KrivkaJ/Projekt_SOC_KiCad/Univerzalni_testovaci_platforma_nejen_pro_IoT_v1/Univerzalni_testovaci_platforma_nejen_pro_IoT_v1.kicad_pcb

## KiCad design Univerzalni_testovaci_platforma_nejen_pro_IoT_v1/Univerzalni_testovaci_platforma_nejen_pro_IoT_v1.kicad_pcb (2024-02-26)

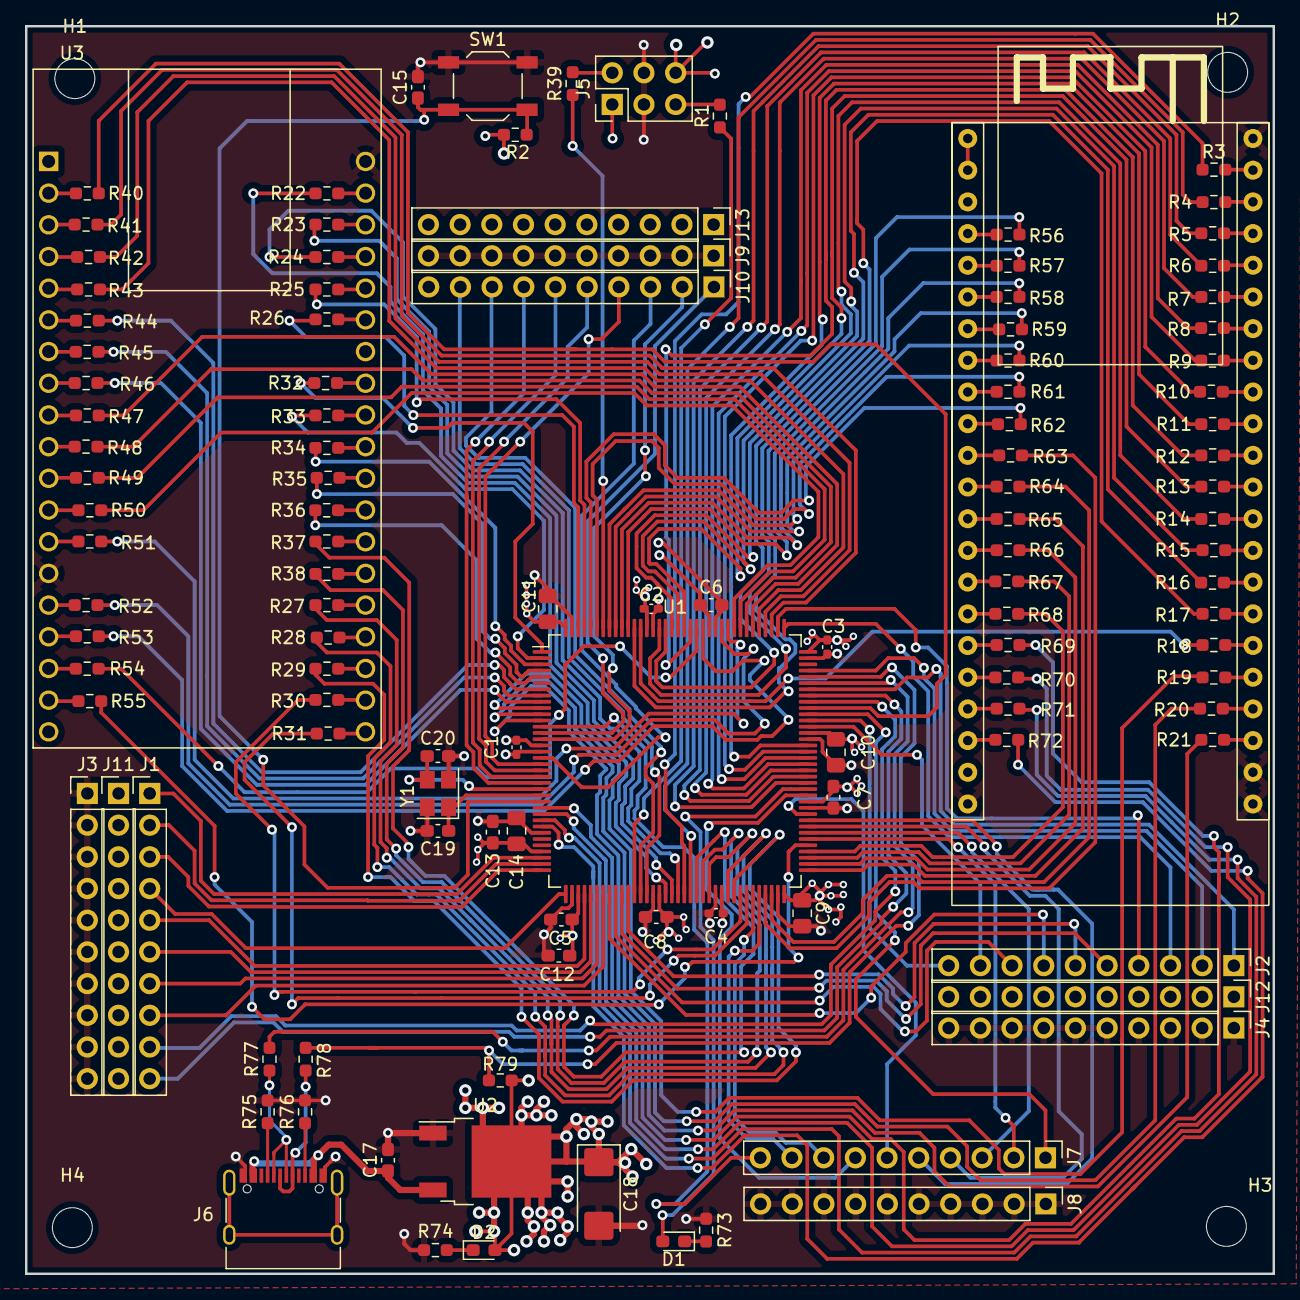
[picture p1: board Univerzalni_testovaci_platforma_nejen_pro_IoT_v1.kicad_pcb from above]

Board: 4 copper layers, 100.0 x 100.0 mm, 123 parts (0 on the bottom side), 197 nets.

Parts:
C1, C2, C3, C4: 10nF; C_0402_1005Metric_Pad0.74x0.62mm_HandSolder
C5, C6, C7, C8: 10nF; C_0603_1608Metric_Pad1.08x0.95mm_HandSolder
C9, C10, C11, C14: 10nF; C_0805_2012Metric_Pad1.18x1.45mm_HandSolder
C12, C15: 4.7uF; C_0603_1608Metric_Pad1.08x0.95mm_HandSolder
C13: 1uF; C_0603_1608Metric_Pad1.08x0.95mm_HandSolder
C17: 22uF; C_0603_1608Metric_Pad1.08x0.95mm_HandSolder
C18: 22µF solid tantalum; CP_EIA-6032-20_AVX-F_Pad2.25x2.35mm_HandSolder
C19, C20: 18pF; C_0603_1608Metric_Pad1.08x0.95mm_HandSolder
D1, D2: RED; LED_0603_1608Metric_Pad1.05x0.95mm_HandSolder
H1, H2, H3, H4: MountingHole; MountingHole_3.2mm_M3
J1, J2, J3, J4, J7, J8, J9, J10, J11, J12, J13: Conn_01x10_Male; PinHeader_1x10_P2.54mm_Vertical
J5: Conn_02x03_Counter_Clockwise; PinHeader_2x03_P2.54mm_Vertical
J6: USB_C_Receptacle; USB_C_Receptacle_XKB_U262-16XN-4BVC11
R1, R39: 100k; R_0603_1608Metric_Pad0.98x0.95mm_HandSolder
R2: 10k; R_0603_1608Metric_Pad0.98x0.95mm_HandSolder
R3, R4, R5, R6, R7, R8, R9, R10, R11, R12, R13, R14, R15, R16, R17, R18, R19, R20, R21, R22, R23, R24, R25, R26, R27, R28, R29, R30, R31, R32, R33, R34, R35, R36, R37, R38, R40, R41, R42, R43, R44, R45, R46, R47, R48, R49, R50, R51, R52, R53, R54, R55, R56, R57, R58, R59, R60, R61, R62, R63, R64, R65, R66, R67, R68, R69, R70, R71, R72: 220R; R_0603_1608Metric_Pad0.98x0.95mm_HandSolder
R73, R74, R79: 1k5; R_0603_1608Metric_Pad0.98x0.95mm_HandSolder
R75, R76: 5k1; R_0603_1608Metric_Pad0.98x0.95mm_HandSolder
R77, R78: 20R; R_0603_1608Metric_Pad0.98x0.95mm_HandSolder
SW1: SW_Push_Dual; SW_SPST_TL3342
U1: STM32F103ZETx; LQFP-144_20x20mm_P0.5mm
U2: AMS1117-3.3; TO-252-2
U3: ESP32-DEVKITC-32D; MODULE_ESP32-DEVKITC-32D
U4: ESP32-S3; ESP32-devkit_v1
Y1: 12Mhz; Crystal_SMD_3225-4Pin_3.2x2.5mm

Connections:
+3.3VA: C13.1, C14.1, U1.33 (VDDA)
+3V3: C1.1, C2.1, C3.1, C4.1, C5.1, C6.1, C7.1, C8.1, C9.1, C10.1, C11.1, C12.1, C18.1, D2.2 (A), J5.1, J5.6, J11.1, J11.2, J11.3, J11.4, J11.5, J11.6, J11.7, J11.8, J11.9, J11.10, J12.1, J12.2, J12.3, J12.4, J12.5, J12.6, J12.7, J12.8, J12.9, J12.10, J13.1, J13.2, J13.3, J13.4, J13.5, J13.6, J13.7, J13.8, J13.9, J13.10, R2.1, R79.1, U1.17 (VDD), U1.39 (VDD), U1.52 (VDD), U1.62 (VDD), U1.72 (VDD), U1.84 (VDD), U1.95 (VDD), U1.108 (VDD), U1.121 (VDD), U1.131 (VDD), U1.144 (VDD), U2.2 (VO)
+5V: C17.1, J6.A4 (VBUS), J6.A9 (VBUS), J6.B4 (VBUS), J6.B9 (VBUS), U2.3 (VI)
/BOOT0: R39.1, U1.138 (BOOT0)
/ESP DEV_KIT J2 pin2: R40.2, U3.J2-2 (EN)
/ESP DEV_KIT J2 pin3: R41.2, U3.J2-3 (SENSOR_VP)
/ESP DEV_KIT J2 pin4: R42.2, U3.J2-4 (SENSOR_VN)
/ESP DEV_KIT J2 pin5: R43.2, U3.J2-5 (IO34)
/ESP DEV_KIT J2 pin6: R44.2, U3.J2-6 (IO35)
/ESP DEV_KIT J2 pin7: R45.2, U3.J2-7 (IO32)
/ESP DEV_KIT J2 pin8: R46.2, U3.J2-8 (IO33)
/ESP DEV_KIT J2 pin9: R47.2, U3.J2-9 (IO25)
/ESP DEV_KIT J2 pin10: R48.2, U3.J2-10 (IO26)
/ESP DEV_KIT J2 pin11: R49.2, U3.J2-11 (IO27)
/ESP DEV_KIT J2 pin12: R50.2, U3.J2-12 (IO14)
/ESP DEV_KIT J2 pin13: R51.2, U3.J2-13 (IO12)
/ESP DEV_KIT J2 pin15: R52.2, U3.J2-15 (IO13)
/ESP DEV_KIT J2 pin16: R53.2, U3.J2-16 (SD2)
/ESP DEV_KIT J2 pin17: R54.2, U3.J2-17 (SD3)
/ESP DEV_KIT J2 pin18: R55.2, U3.J2-18 (CMD)
/ESP DEV_KIT J3 pin2: R22.1, U3.J3-2 (IO23)
/ESP DEV_KIT J3 pin3: R23.1, U3.J3-3 (IO22)
/ESP DEV_KIT J3 pin4: R24.1, U3.J3-4 (TXD0)
/ESP DEV_KIT J3 pin5: R25.1, U3.J3-5 (RXD0)
/ESP DEV_KIT J3 pin6: R26.1, U3.J3-6 (IO21)
/ESP DEV_KIT J3 pin8: R32.1, U3.J3-8 (IO19)
/ESP DEV_KIT J3 pin9: R33.1, U3.J3-9 (IO18)
/ESP DEV_KIT J3 pin10: R34.1, U3.J3-10 (IO5)
/ESP DEV_KIT J3 pin11: R35.1, U3.J3-11 (IO17)
/ESP DEV_KIT J3 pin12: R36.1, U3.J3-12 (IO16)
/ESP DEV_KIT J3 pin13: R37.1, U3.J3-13 (IO4)
/ESP DEV_KIT J3 pin14: R38.1, U3.J3-14 (IO0)
/ESP DEV_KIT J3 pin15: R27.1, U3.J3-15 (IO2)
/ESP DEV_KIT J3 pin16: R28.1, U3.J3-16 (IO15)
/ESP DEV_KIT J3 pin17: R29.1, U3.J3-17 (SD1)
/ESP DEV_KIT J3 pin18: R30.1, U3.J3-18 (SD0)
/ESP DEV_KIT J3 pin19: R31.1, U3.J3-19 (CLK)
/ESP S3 J1 pin4: R56.2, U4.4 (GPIO4)
/ESP S3 J1 pin5: R57.2, U4.5 (GPIO5)
/ESP S3 J1 pin6: R58.2, U4.6 (GPIO6)
/ESP S3 J1 pin7: R59.2, U4.7 (GPIO7)
/ESP S3 J1 pin8: R60.2, U4.8 (GPIO15-RTS0)
/ESP S3 J1 pin9: R61.2, U4.9 (GPIO16-CTS0)
/ESP S3 J1 pin10: R62.2, U4.10 (GPIO17-TX1)
/ESP S3 J1 pin11: R63.2, U4.11 (GPIO18-RX1)
/ESP S3 J1 pin12: R64.2, U4.12 (GPIO8)
/ESP S3 J1 pin13: R65.2, U4.13 (GPIO3!!!D)
/ESP S3 J1 pin14: R66.2, U4.14 (GPIO46!!!D)
/ESP S3 J1 pin15: R67.2, U4.15 (GPIO9)
/ESP S3 J1 pin16: R68.2, U4.16 (GPIO10)
/ESP S3 J1 pin17: R69.2, U4.17 (GPIO11)
/ESP S3 J1 pin18: R70.2, U4.18 (GPIO12)
/ESP S3 J1 pin19: R71.2, U4.19 (GPIO13)
/ESP S3 J1 pin20: R72.2, U4.20 (GPIO14)
/ESP S3 J3 pin2: R3.2, U4.24 (GPIO43-TX0)
/ESP S3 J3 pin3: R4.2, U4.25 (GPIO44-RX0)
/ESP S3 J3 pin4: R5.2, U4.26 (GPIO1)
/ESP S3 J3 pin5: R6.2, U4.27 (GPIO2)
/ESP S3 J3 pin6: R7.2, U4.28 (GPIO42)
/ESP S3 J3 pin7: R8.2, U4.29 (GPIO41)
/ESP S3 J3 pin8: R9.2, U4.30 (GPIO40)
/ESP S3 J3 pin9: R10.2, U4.31 (GPIO39)
/ESP S3 J3 pin10: R11.2, U4.32 (GPIO38)
/ESP S3 J3 pin11: R12.2, U4.33 (GPIO37)
/ESP S3 J3 pin12: R13.2, U4.34 (GPIO36)
/ESP S3 J3 pin13: R14.2, U4.35 (GPIO35)
/ESP S3 J3 pin14: R15.2, U4.36 (GPIO0!!!U)
/ESP S3 J3 pin15: R16.2, U4.37 (GPIO45!!!D)
/ESP S3 J3 pin16: R17.2, U4.38 (GPIO48)
/ESP S3 J3 pin17: R18.2, U4.39 (GPIO47)
/ESP S3 J3 pin18: R19.2, U4.40 (GPIO21)
/ESP S3 J3 pin19: R20.2, U4.41 (GPIO20-D+)
/ESP S3 J3 pin20: R21.2, U4.42 (GPIO19-D-)
BOOT1: R1.1, U1.48 (PB2)
GND: C1.2, C2.2, C3.2, C4.2, C5.2, C6.2, C7.2, C8.2, C9.2, C10.2, C11.2, C12.2, C13.2, C14.2, C15.2, C17.2, C18.2, C19.2, C20.2, J3.1, J3.2, J3.3, J3.4, J3.5, J3.6, J3.7, J3.8, J3.9, J3.10, J4.1, J4.2, J4.3, J4.4, J4.5, J4.6, J4.7, J4.8, J4.9, J4.10, J5.3, J5.4, J6.A1 (GND), J6.A12 (GND), J6.B1 (GND), J6.B12 (GND), J8.1, J8.2, J8.3, J8.4, J8.5, J8.6, J8.7, J8.8, J8.9, J8.10, J9.1, J9.2, J9.3, J9.4, J9.5, J9.6, J9.7, J9.8, J9.9, J9.10, R73.2, R74.2, R75.2, R76.2, SW1.1, U1.16 (VSS), U1.30 (VSSA), U1.38 (VSS), U1.51 (VSS), U1.61 (VSS), U1.71 (VSS), U1.83 (VSS), U1.94 (VSS), U1.107 (VSS), U1.120 (VSS), U1.130 (VSS), U1.143 (VSS), U2.1 (GND), U3.J2-14 (GND1), U3.J3-1 (GND3), U3.J3-7 (GND2), U4.22 (GND), U4.23 (GND), U4.43 (GND), U4.44 (GND), Y1.2, Y1.4
unnamed: C15.1, R2.2, SW1.2, U1.25 (NRST)
unnamed: D1.1 (K), R73.1
unnamed: D1.2 (A), U1.86 (PD15)
unnamed: D2.1 (K), R74.1
unnamed: J1.1, U1.34 (PA0)
unnamed: J1.2, U1.35 (PA1)
unnamed: J1.3, U1.36 (PA2)
unnamed: J1.4, U1.37 (PA3)
unnamed: J1.5, U1.40 (PA4)
unnamed: J1.6, U1.41 (PA5)
unnamed: J1.7, U1.42 (PA6)
unnamed: J1.8, U1.43 (PA7)
unnamed: J1.9, U1.100 (PA8)
unnamed: J1.10, U1.101 (PA9)
unnamed: J5.2, R39.2
unnamed: J5.5, R1.2
unnamed: J6.A5 (CC1), R75.1
unnamed: J6.A6 (D+), J6.B6 (D+), R78.1
unnamed: J6.A7 (D-), J6.B7 (D-), R77.1
unnamed: J6.B5 (CC2), R76.1
unnamed: R3.1, U1.56 (PG0)
unnamed: R4.1, U1.57 (PG1)
unnamed: R5.1, U1.87 (PG2)
unnamed: R6.1, U1.88 (PG3)
unnamed: R7.1, U1.89 (PG4)
unnamed: R8.1, U1.90 (PG5)
unnamed: R9.1, U1.91 (PG6)
unnamed: R10.1, U1.92 (PG7)
unnamed: R11.1, U1.93 (PG8)
unnamed: R12.1, U1.124 (PG9)
unnamed: R13.1, U1.125 (PG10)
unnamed: R14.1, U1.126 (PG11)
unnamed: R15.1, U1.127 (PG12)
unnamed: R16.1, U1.128 (PG13)
unnamed: R17.1, U1.129 (PG14)
unnamed: R18.1, U1.132 (PG15)
unnamed: R19.1, U1.10 (PF0)
unnamed: R20.1, U1.11 (PF1)
unnamed: R21.1, U1.12 (PF2)
unnamed: R22.2, U1.53 (PF13)
unnamed: R23.2, U1.54 (PF14)
unnamed: R24.2, U1.55 (PF15)
unnamed: R25.2, U1.141 (PE0)
unnamed: R26.2, U1.142 (PE1)
unnamed: R27.2, U1.60 (PE9)
unnamed: R28.2, U1.63 (PE10)
unnamed: R29.2, U1.64 (PE11)
unnamed: R30.2, U1.65 (PE12)
unnamed: R31.2, U1.66 (PE13)
unnamed: R32.2, U1.1 (PE2)
unnamed: R33.2, U1.2 (PE3)
unnamed: R34.2, U1.3 (PE4)
unnamed: R35.2, U1.4 (PE5)
unnamed: R36.2, U1.5 (PE6)
unnamed: R37.2, U1.58 (PE7)
unnamed: R38.2, U1.59 (PE8)
unnamed: R40.1, U1.99 (PC9)
unnamed: R41.1, U1.111 (PC10)
unnamed: R42.1, U1.112 (PC11)
unnamed: R43.1, U1.113 (PC12)
unnamed: R44.1, U1.7 (PC13)
unnamed: R45.1, U1.8 (PC14)
unnamed: R46.1, U1.9 (PC15)
unnamed: R47.1, U1.114 (PD0)
unnamed: R48.1, U1.115 (PD1)
unnamed: R49.1, U1.116 (PD2)
unnamed: R50.1, U1.117 (PD3)
unnamed: R51.1, U1.118 (PD4)
unnamed: R52.1, U1.119 (PD5)
unnamed: R53.1, U1.122 (PD6)
unnamed: R54.1, U1.123 (PD7)
unnamed: R55.1, U1.77 (PD8)
unnamed: R56.1, U1.133 (PB3)
unnamed: R57.1, U1.134 (PB4)
unnamed: R58.1, U1.135 (PB5)
unnamed: R59.1, U1.136 (PB6)
unnamed: R60.1, U1.137 (PB7)
unnamed: R61.1, U1.139 (PB8)
unnamed: R62.1, U1.140 (PB9)
unnamed: R63.1, U1.69 (PB10)
unnamed: R64.1, U1.70 (PB11)
unnamed: R65.1, U1.73 (PB12)
unnamed: R66.1, U1.74 (PB13)
unnamed: R67.1, U1.75 (PB14)
unnamed: R68.1, U1.76 (PB15)
unnamed: R69.1, U1.26 (PC0)
unnamed: R70.1, U1.27 (PC1)
unnamed: R71.1, U1.28 (PC2)
unnamed: R72.1, U1.29 (PC3)
OSC_IN: C20.1, U1.23 (RCC_OSC_IN), Y1.3
OSC_OUT: C19.1, U1.24 (RCC_OSC_OUT), Y1.1
PA10: J2.1, U1.102 (PA10)
PA13: J2.2, U1.105 (PA13)
PA14: J2.3, U1.109 (PA14)
PA15: J2.4, U1.110 (PA15)
PB0: J2.5, U1.46 (PB0)
PB1: J2.6, U1.47 (PB1)
PC4: J2.7, U1.44 (PC4)
PC5: J2.8, U1.45 (PC5)
PC6: J2.9, U1.96 (PC6)
PC7: J2.10, U1.97 (PC7)
PC8: J7.1, U1.98 (PC8)
PD9: J7.2, U1.78 (PD9)
PD10: J7.3, U1.79 (PD10)
PD11: J7.4, U1.80 (PD11)
PD12: J7.5, U1.81 (PD12)
PD13: J7.6, U1.82 (PD13)
PD14: J7.7, U1.85 (PD14)
PE14: J7.8, U1.67 (PE14)
PE15: J7.9, U1.68 (PE15)
PF3: J7.10, U1.13 (PF3)
PF4: J10.1, U1.14 (PF4)
PF5: J10.2, U1.15 (PF5)
PF6: J10.3, U1.18 (PF6)
PF7: J10.4, U1.19 (PF7)
PF8: J10.5, U1.20 (PF8)
PF9: J10.6, U1.21 (PF9)
PF10: J10.7, U1.22 (PF10)
PF11: J10.8, U1.49 (PF11)
PF12: J10.9, U1.50 (PF12)
USB_D+: R78.2, R79.2, U1.104 (PA12)
USB_D-: R77.2, U1.103 (PA11)
