KrivkaJ/Projekt_SOC_KiCad/(commit log)

2023-12-20 průběžná commit
    [Univerzální_testovací_platforma_nejen_pro_IoT_v1.kicad_pcb, Univerzální_testovací_platforma_nejen_pro_IoT_v1.kicad_sch]
2023-12-20 začátek hierarchických sheetů
    [Univerzální_testovací_platforma_nejen_pro_IoT_v1.kicad_sch, untitled.kicad_sch]
2023-12-20 odstranění diakritiky z názvu
    [Univerzalni_testovaci_platforma_nejen_pro_IoT_v1.kicad_pcb, Univerzalni_testovaci_platforma_nejen_pro_IoT_v1.kicad_sch, Univerzální_testovací_platforma_nejen_pro_IoT_v1.kicad_pcb, untitled.kicad_sch]
2023-12-21 průběžný commit
    [Univerzalni_testovaci_platforma_nejen_pro_IoT_v1.kicad_sch]
2024-01-25 schema hotovo
    [Univerzalni_testovaci_platforma_nejen_pro_IoT_v1.kicad_pcb, Univerzalni_testovaci_platforma_nejen_pro_IoT_v1.kicad_sch, untitled.kicad_sch]
2024-01-26 asi hotovo
    [Univerzalni_testovaci_platforma_nejen_pro_IoT_v1.kicad_pcb]
2024-01-26 uplně hotovo
    [Univerzalni_testovaci_platforma_nejen_pro_IoT_v1.kicad_pcb]
2024-01-31 jdu to objednat
    [Univerzalni_testovaci_platforma_nejen_pro_IoT_v1-CmtUser.gbr, Univerzalni_testovaci_platforma_nejen_pro_IoT_v1-CuBottom.gbl, Univerzalni_testovaci_platforma_nejen_pro_IoT_v1-CuTop.gtl, Univerzalni_testovaci_platforma_nejen_pro_IoT_v1-EdgeCuts.gm1, Univerzalni_testovaci_platforma_nejen_pro_IoT_v1-MaskBottom.gbs, Univerzalni_testovaci_platforma_nejen_pro_IoT_v1-MaskTop.gts, Univerzalni_testovaci_pl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]
2024-02-24 změna usměrňovače napětí na správný
    [Univerzalni_testovaci_platforma_nejen_pro_IoT_v1-CmtUser.gbr, Univerzalni_testovaci_platforma_nejen_pro_IoT_v1-CuBottom.gbl, Univerzalni_testovaci_platforma_nejen_pro_IoT_v1-CuTop.gtl, Univerzalni_testovaci_platforma_nejen_pro_IoT_v1-EdgeCuts.gm1, Univerzalni_testovaci_platforma_nejen_pro_IoT_v1-MaskBottom.gbs, Univerzalni_testovaci_platforma_nejen_pro_IoT_v1-MaskTop.gts, Univerzalni_testovaci_pl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]
2024-02-26 změny schématu pro lepší focení
    [Univerzalni_testovaci_platforma_nejen_pro_IoT_v1.kicad_pcb, Univerzalni_testovaci_platforma_nejen_pro_IoT_v1.kicad_sch]
